Hanthebot/crustrusk/cover_etc/base_6col/crustrusk_bottom.dxf

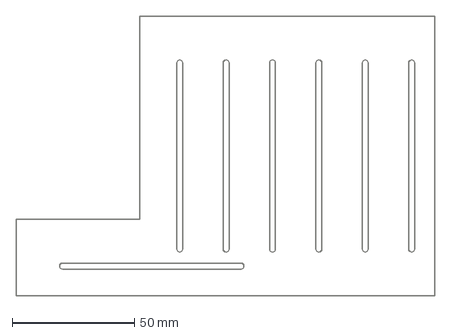
[picture p2: CAD file, 2026-10-17]
cover_etc/base_6col/crustrusk_bottom.dxf
171.5 x 114.3 mm
