Hanthebot/crustrusk/pcb/col2/cover/col2-cover.dxf

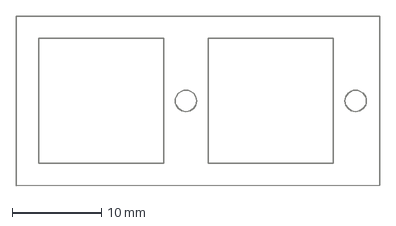
[picture p3: CAD file, 2026-10-18]
pcb/col2/cover/col2-cover.dxf
40.7 x 19.0 mm
