Hanthebot/crustrusk/pcb/col3/cover/col3-cover.dxf

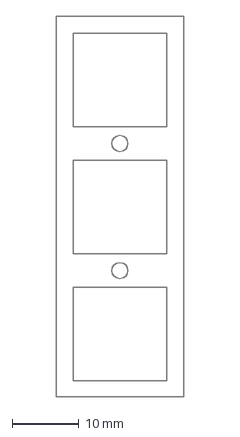
[picture p4: CAD file, 2026-10-17]
pcb/col3/cover/col3-cover.dxf
19.0 x 56.9 mm
