Hanthebot/crustrusk/pcb/col4/cover/col4-cover.dxf

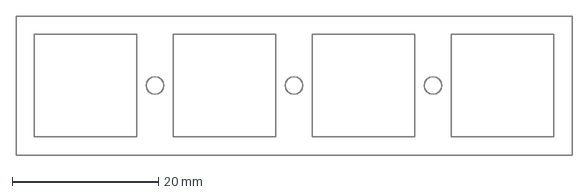
[picture p5: CAD file, 2026-10-18]
pcb/col4/cover/col4-cover.dxf
76.0 x 19.0 mm
