Hanthebot/crustrusk/pcb/col5/cover/col5-cover.dxf

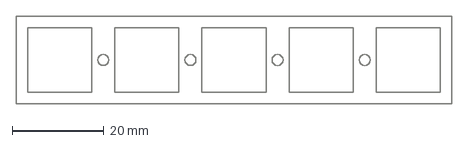
[picture p6: CAD file, 2026-10-18]
pcb/col5/cover/col5-cover.dxf
95.0 x 19.0 mm
