Hanthebot/crustrusk/pcb/thumb3-boardloaf/cover/crustrusk_top_thumb.dxf

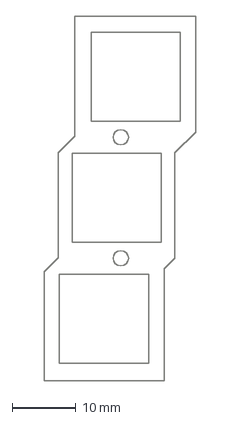
[picture p7: CAD file, 2026-10-17]
pcb/thumb3-boardloaf/cover/crustrusk_top_thumb.dxf
23.8 x 57.3 mm
