Hanthebot/crustrusk/pcb_bundle/central_4x3key_thumb_knob/cover/crustrusk_top.dxf

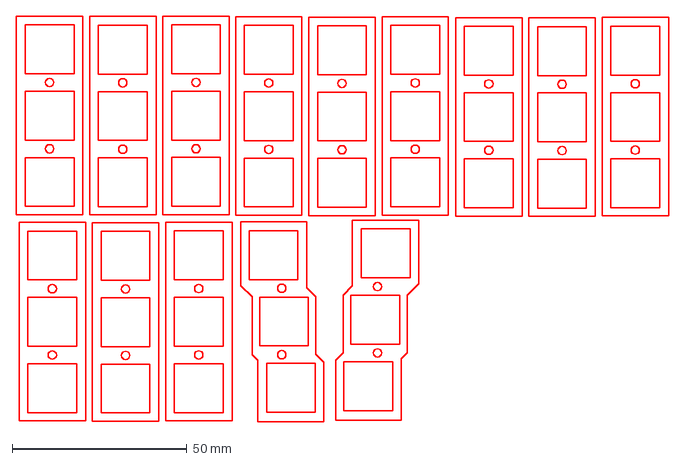
[picture p8: CAD file, 2026-10-17]
pcb_bundle/central_4x3key_thumb_knob/cover/crustrusk_top.dxf
186.7 x 116.2 mm
