Hanthebot/crustrusk/pcb_bundle/central_4x3key_thumb_knob/cover/crustrusk_bottom_mdf.dxf

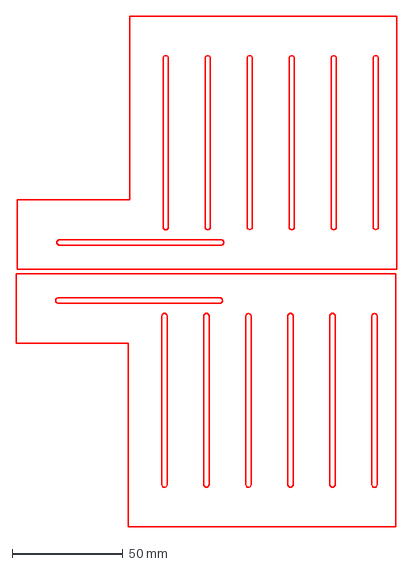
[picture p9: CAD file, 2026-10-17]
pcb_bundle/central_4x3key_thumb_knob/cover/crustrusk_bottom_mdf.dxf
172.1 x 230.9 mm
