Hanthebot/crustrusk/pcb_bundle/thumb_bundle_2/thumb_bundle_2.kicad_pcb

## KiCad design pcb_bundle/thumb_bundle_2/thumb_bundle_2.kicad_pcb (2026-10-25)

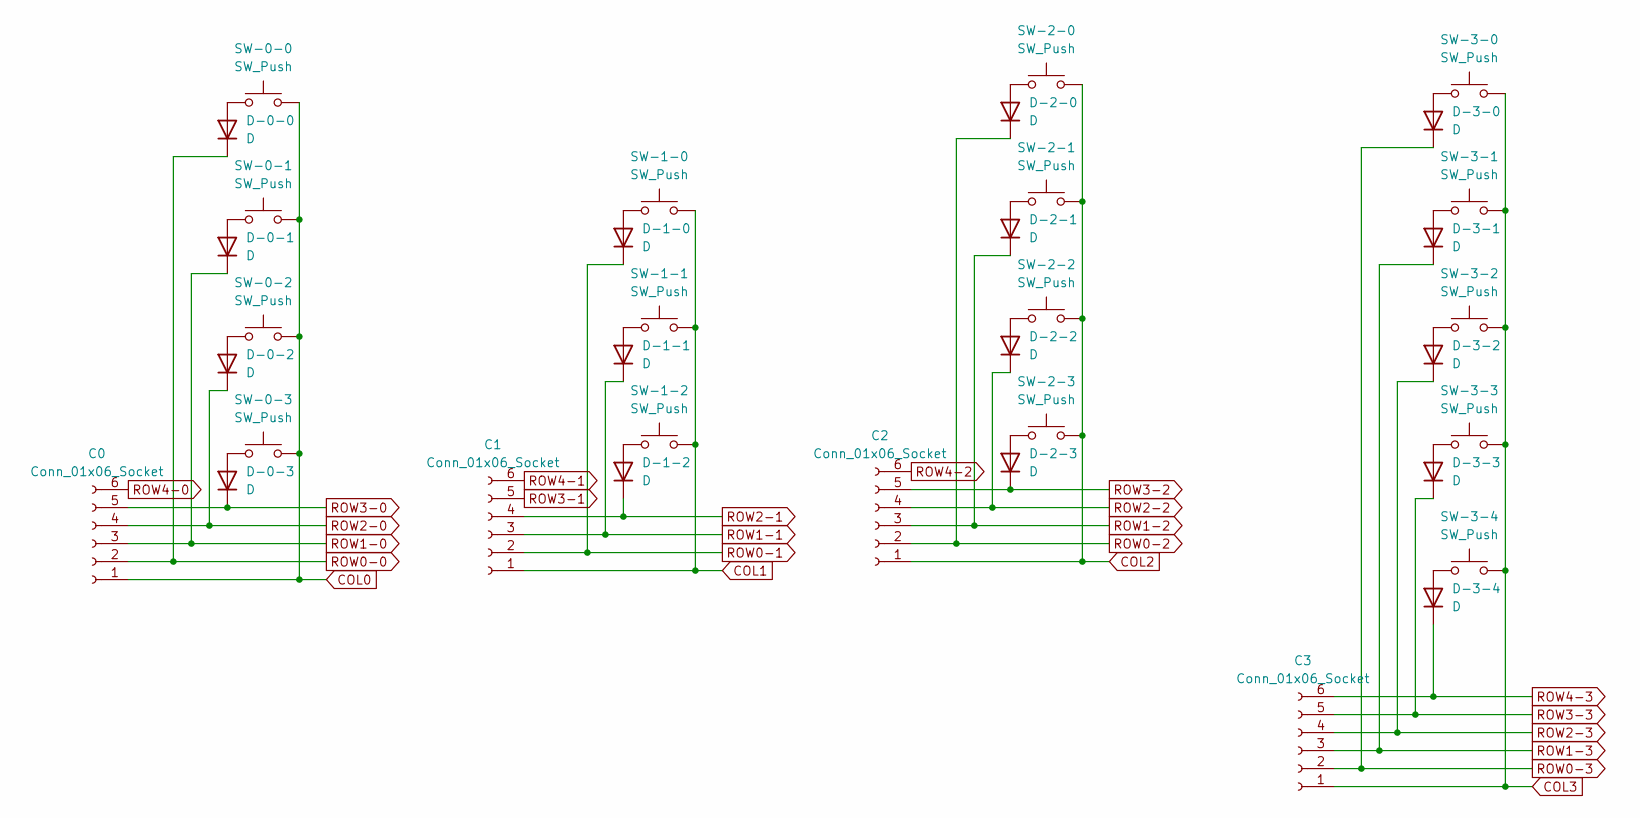
[picture p10: schematic thumb_bundle_2.kicad_sch]

Parts:
C0, C1, C2, C3: Conn_01x06_Socket; reversible JST_PH_S6B-PH-K_1x06_P2.00mm_Horizontal
D-0-0, D-0-1, D-0-2, D-0-3, D-1-0, D-1-1, D-1-2, D-2-0, D-2-1, D-2-2, D-2-3, D-3-0, D-3-1, D-3-2, D-3-3, D-3-4: D; Diode_TH_SMD_REVERSIBLE
SW-0-0, SW-0-1, SW-0-2, SW-0-3, SW-1-0, SW-1-1, SW-1-2, SW-2-0, SW-2-1, SW-2-2, SW-2-3, SW-3-0, SW-3-1, SW-3-2, SW-3-3, SW-3-4: SW_Push; Kailh_hotswap_only_socket_MX_optional_reversible-MIRROR

Connections:
COL0: C0.1, SW-0-0.2, SW-0-1.2, SW-0-2.2, SW-0-3.2; also elsewhere on the board
COL1: C1.1, SW-1-0.2, SW-1-1.2, SW-1-2.2
COL2: C2.1, SW-2-0.2, SW-2-1.2, SW-2-2.2, SW-2-3.2
COL3: C3.1, SW-3-0.2, SW-3-1.2, SW-3-2.2, SW-3-3.2, SW-3-4.2
unnamed: D-0-0.2 (A), SW-0-0.1
unnamed: D-0-1.2 (A), SW-0-1.1
unnamed 6: D-0-2.2 (A), SW-0-2.1; also elsewhere on the board
unnamed: D-0-3.2 (A), SW-0-3.1
unnamed: D-1-0.2 (A), SW-1-0.1
unnamed: D-1-1.2 (A), SW-1-1.1
unnamed: D-1-2.2 (A), SW-1-2.1
unnamed: D-2-0.2 (A), SW-2-0.1
unnamed: D-2-1.2 (A), SW-2-1.1
unnamed: D-2-2.2 (A), SW-2-2.1
unnamed: D-2-3.2 (A), SW-2-3.1
unnamed: D-3-0.2 (A), SW-3-0.1
unnamed: D-3-1.2 (A), SW-3-1.1
unnamed: D-3-2.2 (A), SW-3-2.1
unnamed: D-3-3.2 (A), SW-3-3.1
unnamed: D-3-4.2 (A), SW-3-4.1
ROW0-0: C0.2, D-0-0.1 (K)
ROW0-1: C1.2, D-1-0.1 (K)
ROW0-2: C2.2, D-2-0.1 (K)
ROW0-3: C3.2, D-3-0.1 (K)
ROW1-0: C0.3, D-0-1.1 (K)
ROW1-1: C1.3, D-1-1.1 (K)
ROW1-2: C2.3, D-2-1.1 (K)
ROW1-3: C3.3, D-3-1.1 (K)
ROW2-0: C0.4, D-0-2.1 (K)
ROW2-1: C1.4, D-1-2.1 (K)
ROW2-2: C2.4, D-2-2.1 (K)
ROW2-3: C3.4, D-3-2.1 (K)
ROW3-0: C0.5, D-0-3.1 (K)
ROW3-1: C1.5
ROW3-2: C2.5, D-2-3.1 (K)
ROW3-3: C3.5, D-3-3.1 (K)
ROW4-0: C0.6
ROW4-1: C1.6
ROW4-2: C2.6
ROW4-3: C3.6, D-3-4.1 (K)

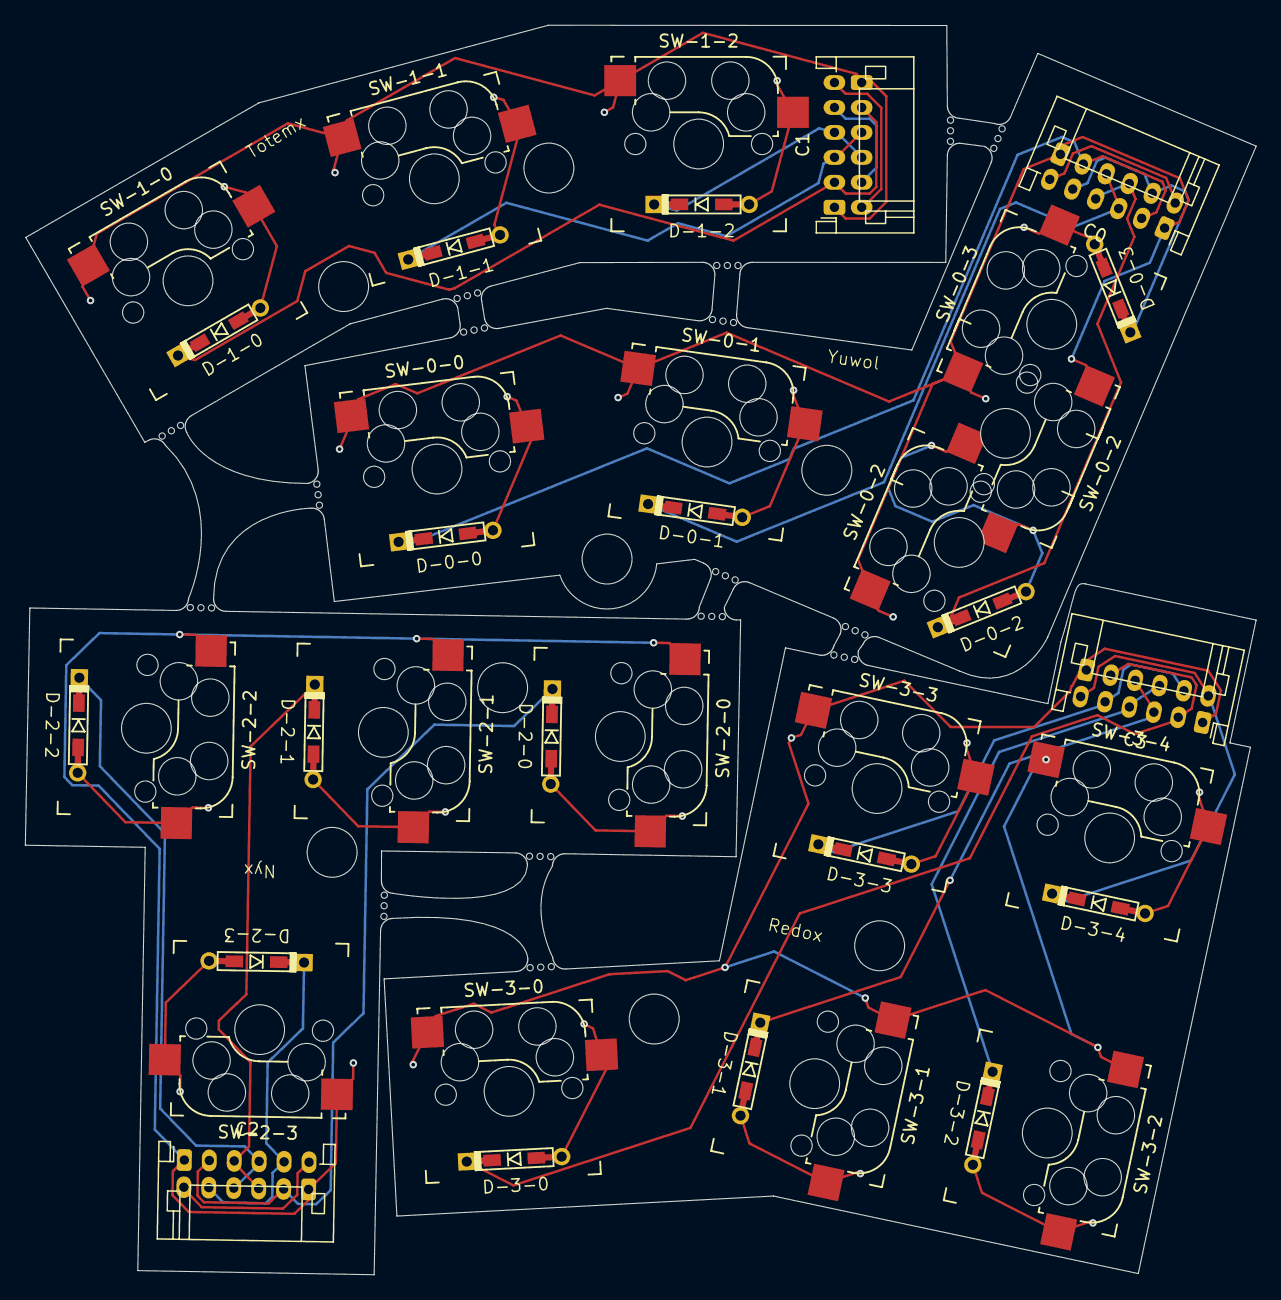
[picture p11: board thumb_bundle_2.kicad_pcb from above]

Board: 2 copper layers, 98.7 x 100.2 mm, 37 parts (0 on the bottom side), 36 nets.

Other parts of the board:
SW-0-2#2: SW_Push; Kailh_hotswap_only_socket_MX_optional_reversible-MIRROR

Their connections:
COL0: SW-0-2#2.2; also elsewhere on the board
unnamed 6: SW-0-2#2.1; also elsewhere on the board
