Hanthebot/crustrusk/pcb/main_board/main_board.kicad_pcb

## KiCad design pcb/main_board/main_board.kicad_pcb (2026-10-22)

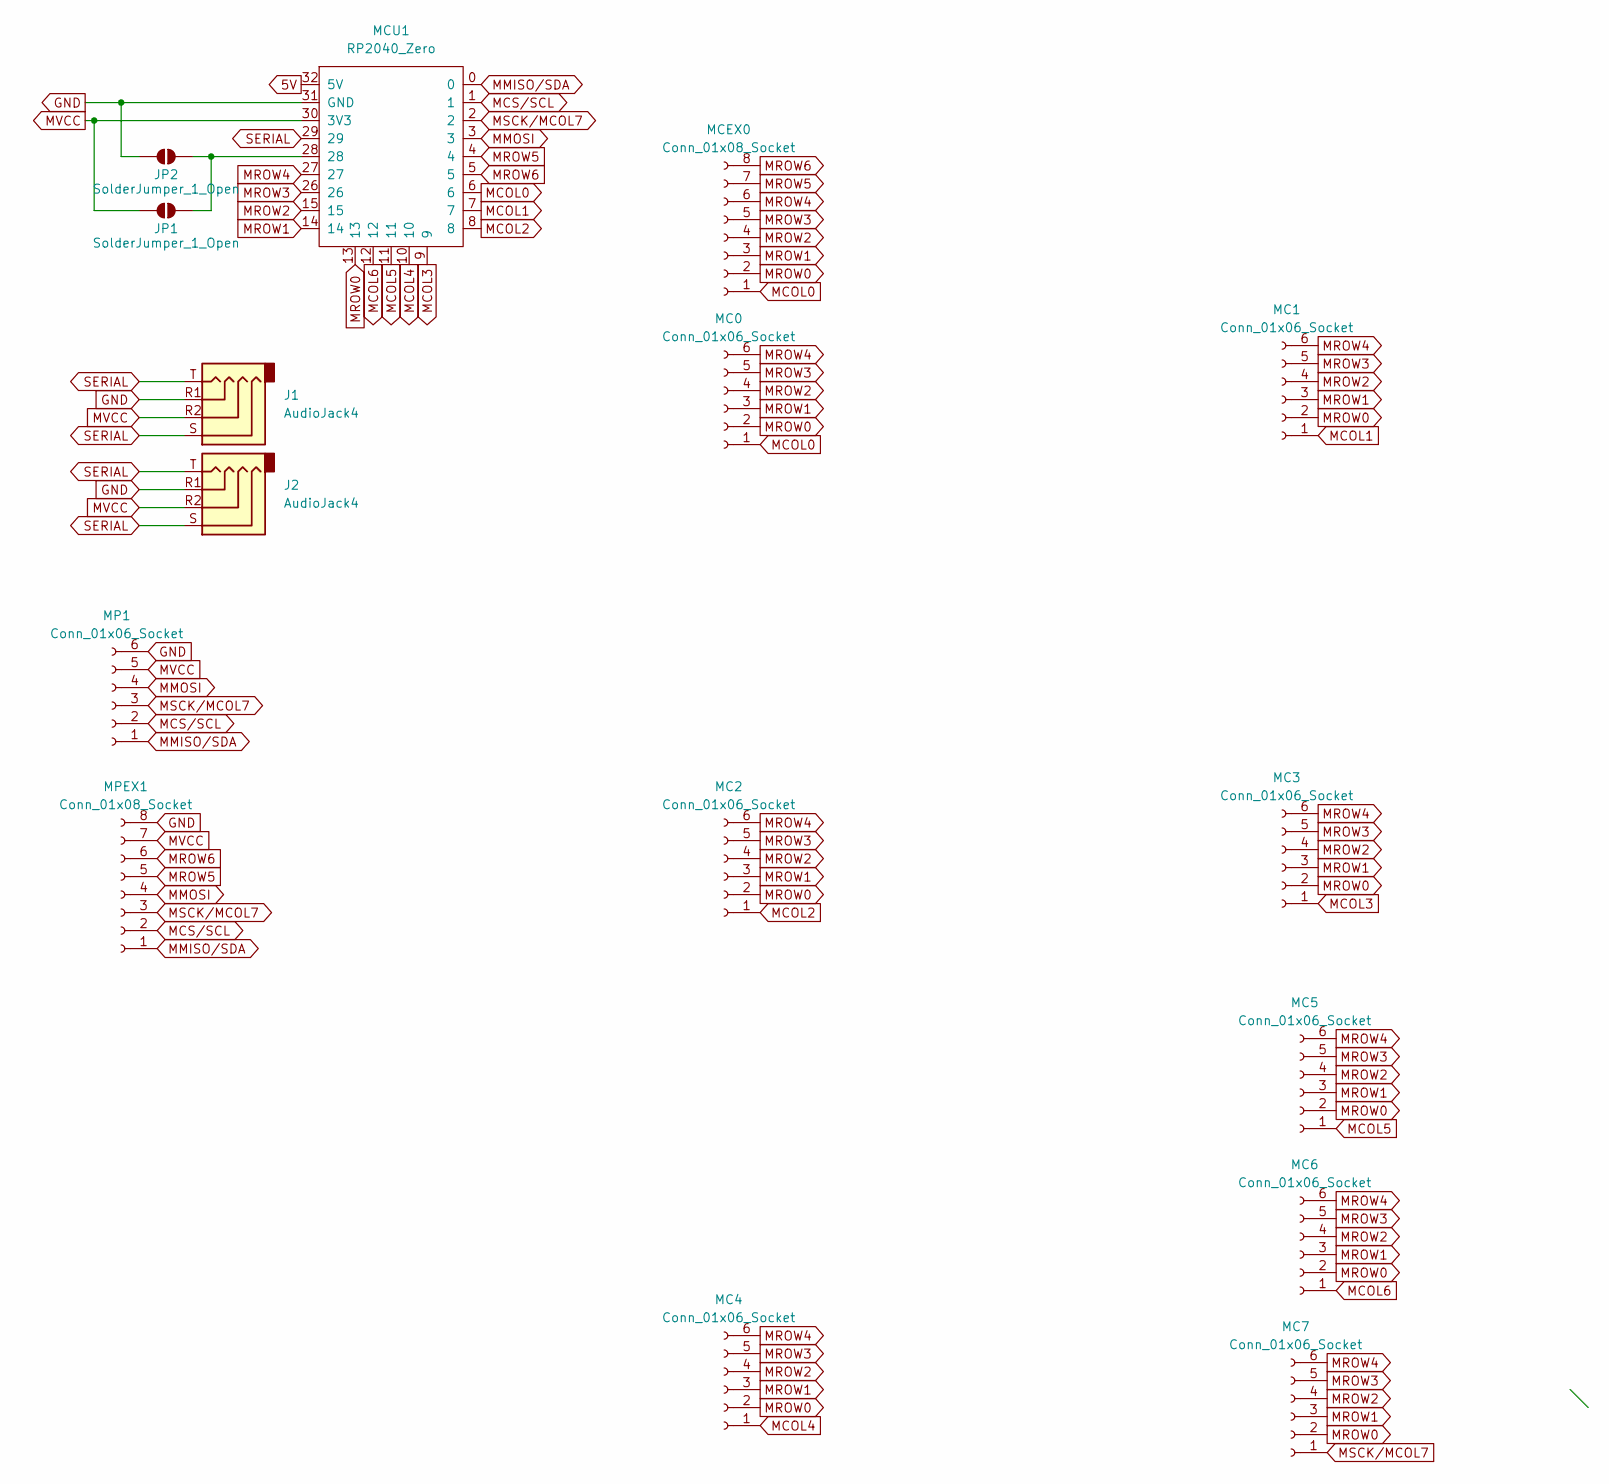
[picture p12: schematic main_board.kicad_sch]

Parts:
J1, J2: AudioJack4; TRRS-PJ-320A_PIN
JP1, JP2: SolderJumper_1_Open; SolderJumper-2_P1.3mm_Open_TrianglePad1.0x1.5mm
MC0, MC1, MC2, MC3, MC4, MC5, MC6, MC7: Conn_01x06_Socket; JST_PH_B6B-PH-K_1x06_P2.00mm_Vertical
MCEX0: Conn_01x08_Socket; JST_PH_B8B-PH-K_1x08_P2.00mm_Vertical
MCU1: RP2040_Zero; RP2040-Zero-THT-mm
MP1: Conn_01x06_Socket; JST_PH_B6B-PH-K_1x06_P2.00mm_Vertical
MPEX1: Conn_01x08_Socket; JST_PH_B8B-PH-K_1x08_P2.00mm_Vertical

Connections:
5V: MCU1.32 (5V)
GND: J1.R1, J2.R1, JP2.1 (A), MCU1.31 (GND), MP1.6, MPEX1.8
MCOL0: MC0.1, MCEX0.1, MCU1.6
MCOL1: MC1.1, MCU1.7
MCOL2: MC2.1, MCU1.8
MCOL3: MC3.1, MCU1.9
MCOL4: MC4.1, MCU1.10
MCOL5: MC5.1, MCU1.11
MCOL6: MC6.1, MCU1.12
MCS/SCL: MCU1.1, MP1.2, MPEX1.2
MMISO/SDA: MCU1.0, MP1.1, MPEX1.1
MMOSI: MCU1.3, MP1.4, MPEX1.4
MROW0: MC0.2, MC1.2, MC2.2, MC3.2, MC4.2, MC5.2, MC6.2, MC7.2, MCEX0.2, MCU1.13
MROW1: MC0.3, MC1.3, MC2.3, MC3.3, MC4.3, MC5.3, MC6.3, MC7.3, MCEX0.3, MCU1.14
MROW2: MC0.4, MC1.4, MC2.4, MC3.4, MC4.4, MC5.4, MC6.4, MC7.4, MCEX0.4, MCU1.15
MROW3: MC0.5, MC1.5, MC2.5, MC3.5, MC4.5, MC5.5, MC6.5, MC7.5, MCEX0.5, MCU1.26
MROW4: MC0.6, MC1.6, MC2.6, MC3.6, MC4.6, MC5.6, MC6.6, MC7.6, MCEX0.6, MCU1.27
MROW5: MCEX0.7, MCU1.4, MPEX1.5
MROW6: MCEX0.8, MCU1.5, MPEX1.6
MSCK/MCOL7: MC7.1, MCU1.2, MP1.3, MPEX1.3
MVCC: J1.R2, J2.R2, JP1.1 (A), MCU1.30 (3V3), MP1.5, MPEX1.7
unnamed: JP1.2 (B), JP2.2 (B), MCU1.28
SERIAL: J1.S, J1.T, J2.S, J2.T, MCU1.29

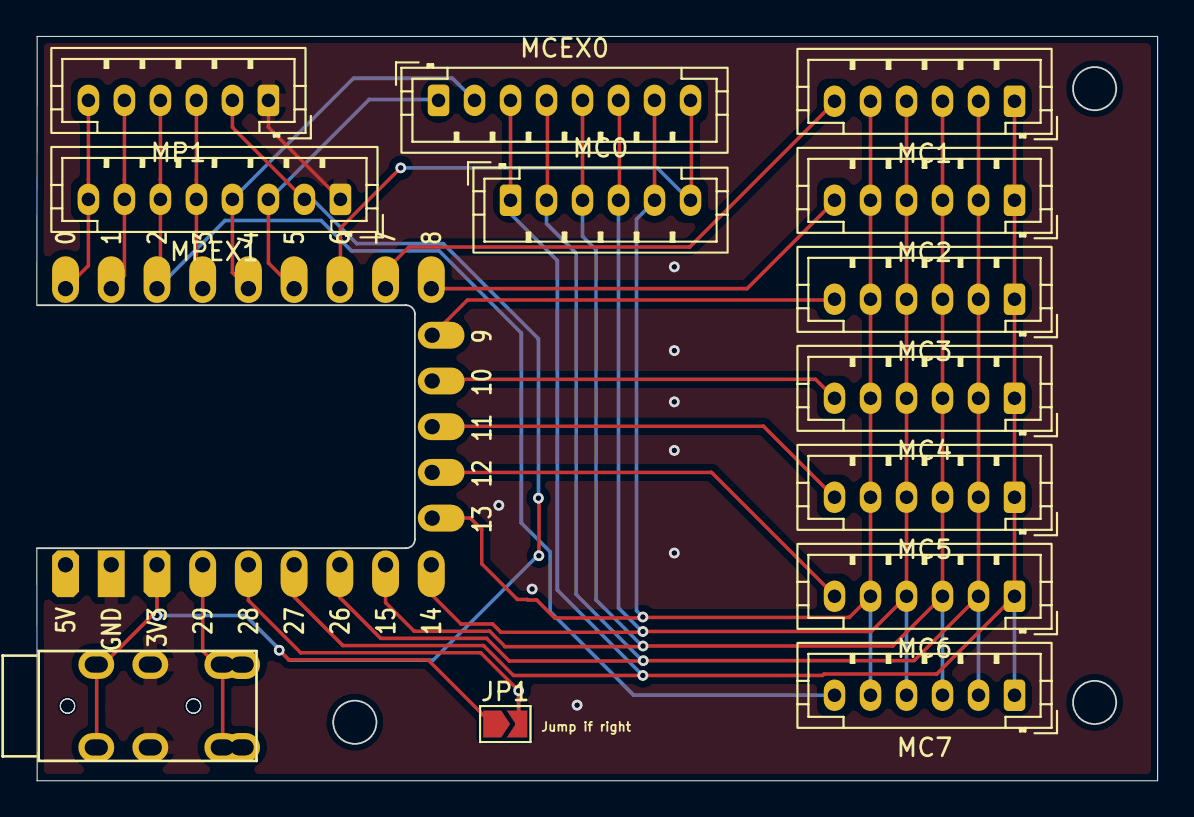
[picture p13: board main_board.kicad_pcb from above]

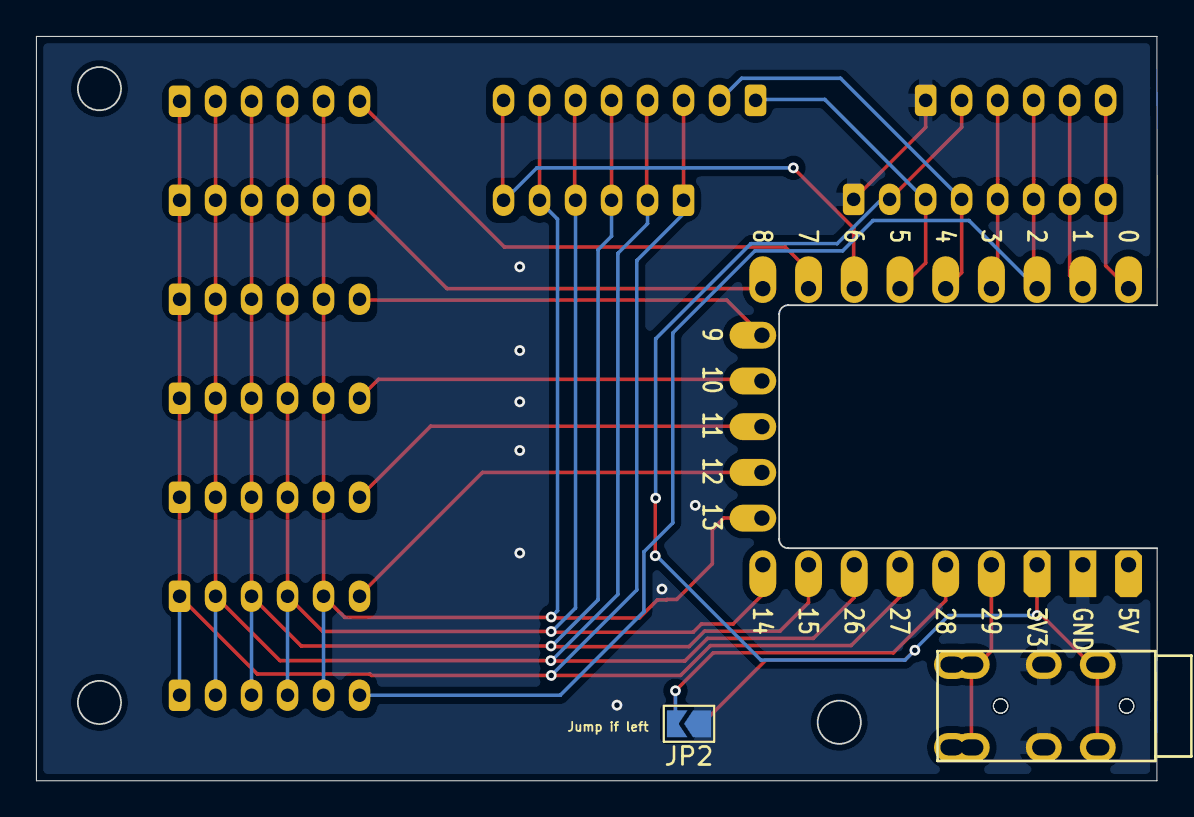
[picture p14: board main_board.kicad_pcb from below]

Board: 2 copper layers, 62.3 x 41.3 mm, 19 parts (2 on the bottom side), 22 nets.

Other parts of the board:
Ref**: Val**; hole-m2-screw
Ref**#2, Ref**#3: Val**; hole-m2-screw
