Hanthebot/crustrusk/(commit log)

2026-10-17 incomplete init
    [crustrusk-B_Cu.gbr, crustrusk-B_Mask.gbr, crustrusk-B_Paste.gbr, crustrusk-B_Silkscreen.gbr, crustrusk-Edge_Cuts.gbr, crustrusk-F_Cu.gbr, crustrusk-F_Mask.gbr, crustrusk-F_Paste.gbr]
2026-10-18 added col3 and thumb pcb unit
    [crustrusk.kicad_sch]
2026-10-18 renamed folder
    [crustrusk.kicad_sch, crustrusk_top_col.dxf, crustrusk_top_thumb.dxf, crustrusk_top_thumb.kicad_pcb]
2026-10-18 added peripheral unit
    [crustrusk.kicad_sch]
2026-10-18 changed mainboard jst socket direction, added mousebite
    [crustrusk-B_Cu.gbr, crustrusk-B_Mask.gbr, crustrusk-B_Paste.gbr, crustrusk-B_Silkscreen.gbr, crustrusk-Edge_Cuts.gbr, crustrusk-F_Cu.gbr, crustrusk-F_Mask.gbr, crustrusk-F_Paste.gbr]
2026-10-18 added main board as unit
    [crustrusk.kicad_sch]
2026-10-18 Added 2, 4, 5 key column units
    [col2-cover.dxf, col2-cover.kicad_pcb, col2.kicad_pcb, col2.kicad_sch, col4-cover.dxf, col4-cover.kicad_pcb, col4.kicad_pcb, col4.kicad_sch]
2026-10-19 Moved gerber to correct location
    [crustrusk-B_Cu.gbr, crustrusk-B_Mask.gbr, crustrusk-B_Paste.gbr, crustrusk-B_Silkscreen.gbr, crustrusk-Edge_Cuts.gbr, crustrusk-F_Cu.gbr, crustrusk-F_Mask.gbr, crustrusk-F_Paste.gbr]
2026-10-19 adjusted col unit pcb
    [col2.kicad_pcb, col2.kicad_sch, col4.kicad_pcb, col5.kicad_pcb]
2026-10-19 extra key bundle v0.1
    [4x4_1x2_1x5key-B_Cu.gbr, 4x4_1x2_1x5key-B_Mask.gbr, 4x4_1x2_1x5key-B_Paste.gbr, 4x4_1x2_1x5key-B_Silkscreen.gbr, 4x4_1x2_1x5key-Edge_Cuts.gbr, 4x4_1x2_1x5key-F_Cu.gbr, 4x4_1x2_1x5key-F_Mask.gbr, 4x4_1x2_1x5key-F_Paste.gbr]
2026-10-19 v0.1b: manufacturer friendly mousebite
    [4x4_1x2_1x5key-B_Cu.gbr, 4x4_1x2_1x5key-B_Mask.gbr, 4x4_1x2_1x5key-B_Paste.gbr, 4x4_1x2_1x5key-B_Silkscreen.gbr, 4x4_1x2_1x5key-Edge_Cuts.gbr, 4x4_1x2_1x5key-F_Cu.gbr, 4x4_1x2_1x5key-F_Mask.gbr, 4x4_1x2_1x5key-F_Paste.gbr]
2026-10-22 Added forgotten PCB file
    [crustrusk.kicad_pcb]
2026-10-22 Added forgotten PCB file - 2
    [crustrusk.kicad_pcb]
2026-10-22 Renamed files
    [col3-cover.dxf, col3-cover.kicad_pcb, col3.kicad_pcb, col3.kicad_sch, main_board.kicad_pcb, main_board.kicad_sch, peripheral_ec11.kicad_pcb, peripheral_ec11.kicad_sch]
2026-10-22 renamed more files
    [thumb3-boardloaf-cover.kicad_pcb]
2026-10-22 Added thumb cluster units
    [thumb2-sweep.kicad_pcb, thumb2-sweep.kicad_sch, thumb3-boardloaf.kicad_pcb, thumb3-boardloaf.kicad_sch, thumb3-cantor.kicad_pcb, thumb3-cantor.kicad_sch, thumb3-cheapino.kicad_pcb, thumb3-cheapino.kicad_sch]
2026-10-22 thumb bundle 1: schematic and basic pcb
    [thumb_bundle_1.kicad_pcb, thumb_bundle_1.kicad_sch]
2026-10-23 net synced and gerber created
    [thumb_bundle_1-B_Cu.gbr, thumb_bundle_1-B_Mask.gbr, thumb_bundle_1-B_Paste.gbr, thumb_bundle_1-B_Silkscreen.gbr, thumb_bundle_1-Edge_Cuts.gbr, thumb_bundle_1-F_Cu.gbr, thumb_bundle_1-F_Mask.gbr, thumb_bundle_1-F_Paste.gbr]
2026-10-23 Added label to thumb clusters
    [thumb2-sweep.kicad_pcb, thumb3-boardloaf.kicad_pcb, thumb3-cantor.kicad_pcb, thumb3-cheapino.kicad_pcb, thumb3-corne.kicad_pcb, thumb4-elephant42.kicad_pcb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]
2026-10-24 Added thumb cluster units 2
    [thumb3-totemx.kicad_pcb, thumb3-totemx.kicad_sch, thumb4-nyx.kicad_pcb, thumb4-nyx.kicad_sch, thumb4-yuwol.kicad_pcb, thumb4-yuwol.kicad_sch, thumb5-redox.kicad_pcb, thumb5-redox.kicad_sch]
2026-10-24 Updated Nyx thumb slightly
    [thumb4-nyx.kicad_pcb]
2026-10-24 thumb bundle 2 beta
    [thumb_bundle_2-B_Cu.gbr, thumb_bundle_2-B_Mask.gbr, thumb_bundle_2-B_Paste.gbr, thumb_bundle_2-B_Silkscreen.gbr, thumb_bundle_2-Edge_Cuts.gbr, thumb_bundle_2-F_Cu.gbr, thumb_bundle_2-F_Mask.gbr, thumb_bundle_2-F_Paste.gbr]
2026-10-24 Nyx thumb update 2
    [thumb4-nyx.kicad_pcb]
2026-10-24 Regenerated bundle
    [thumb_bundle_2-B_Cu.gbr, thumb_bundle_2-B_Mask.gbr, thumb_bundle_2-B_Paste.gbr, thumb_bundle_2-B_Silkscreen.gbr, thumb_bundle_2-Edge_Cuts.gbr, thumb_bundle_2-F_Cu.gbr, thumb_bundle_2-F_Mask.gbr, thumb_bundle_2-F_Paste.gbr]
2026-10-25 Updated asym col units
    [asym-col-corne.kicad_pcb, asym-col-corne.kicad_sch, asym-col-lily58.kicad_pcb, asym-col-lily58.kicad_sch, asym-col-square.kicad_pcb, asym-col-square.kicad_sch, asym-col-totemx.kicad_pcb, asym-col-totemx.kicad_sch]
2026-10-25 Generated bundle and gerber
    [asym_col_bundle_1-B_Cu.gbr, asym_col_bundle_1-B_Mask.gbr, asym_col_bundle_1-B_Paste.gbr, asym_col_bundle_1-B_Silkscreen.gbr, asym_col_bundle_1-Edge_Cuts.gbr, asym_col_bundle_1-F_Cu.gbr, asym_col_bundle_1-F_Mask.gbr, asym_col_bundle_1-F_Paste.gbr]
2026-10-25 Update on thumb bundle 2 for production
    [thumb_bundle_2-B_Cu.gbr, thumb_bundle_2-B_Mask.gbr, thumb_bundle_2-B_Paste.gbr, thumb_bundle_2-B_Silkscreen.gbr, thumb_bundle_2-Edge_Cuts.gbr, thumb_bundle_2-F_Cu.gbr, thumb_bundle_2-F_Mask.gbr, thumb_bundle_2-F_Paste.gbr]
